gilberto-coelho/Automated-6-Port-Injection-Valve/STL-files/Main Holder.stl

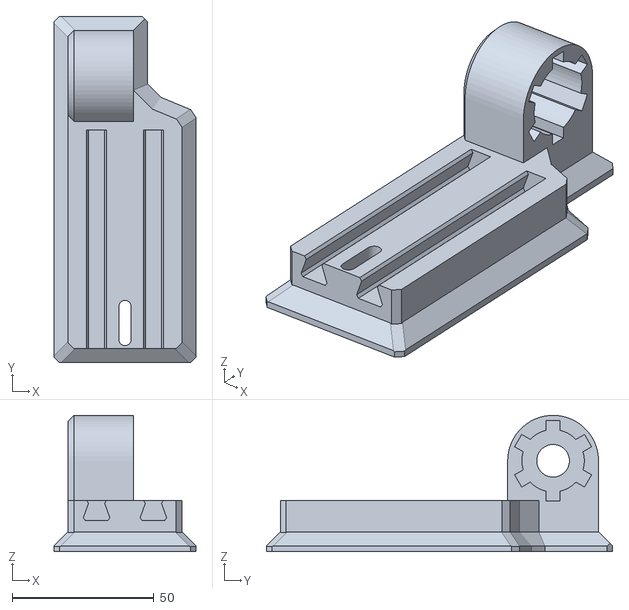
[picture p1: CAD file, 2026-10-12]
STL-files/Main Holder.stl
50.0 x 122.0 x 48.0
