gilberto-coelho/Automated-6-Port-Injection-Valve/STL-files/Gear Servo.stl

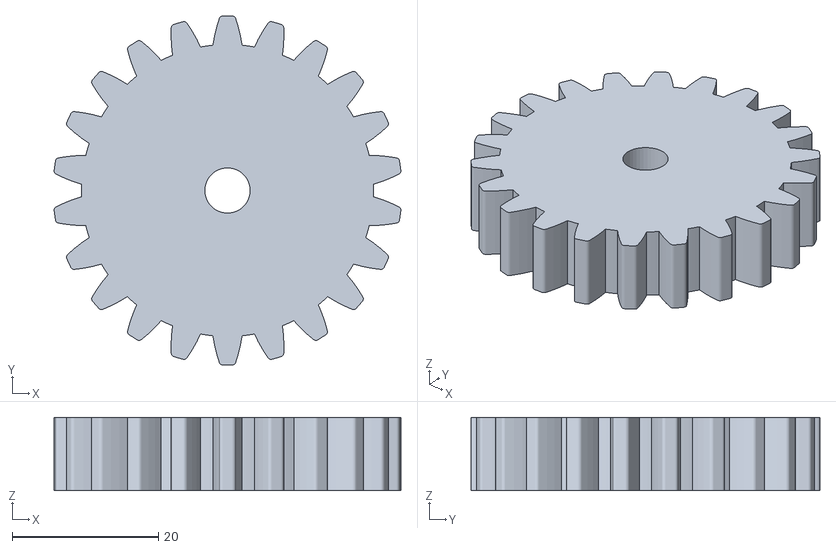
[picture p2: CAD file, 2026-10-12]
STL-files/Gear Servo.stl
47.5 x 47.8 x 10.0
