gilberto-coelho/Automated-6-Port-Injection-Valve/STL-files/Lid.stl

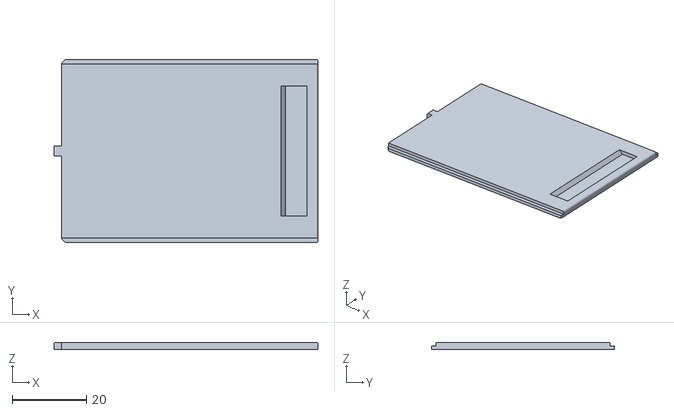
[picture p3: CAD file, 2026-10-12]
STL-files/Lid.stl
71.0 x 49.2 x 2.00
