gilberto-coelho/Automated-6-Port-Injection-Valve/STL-files/Box Electronics.stl

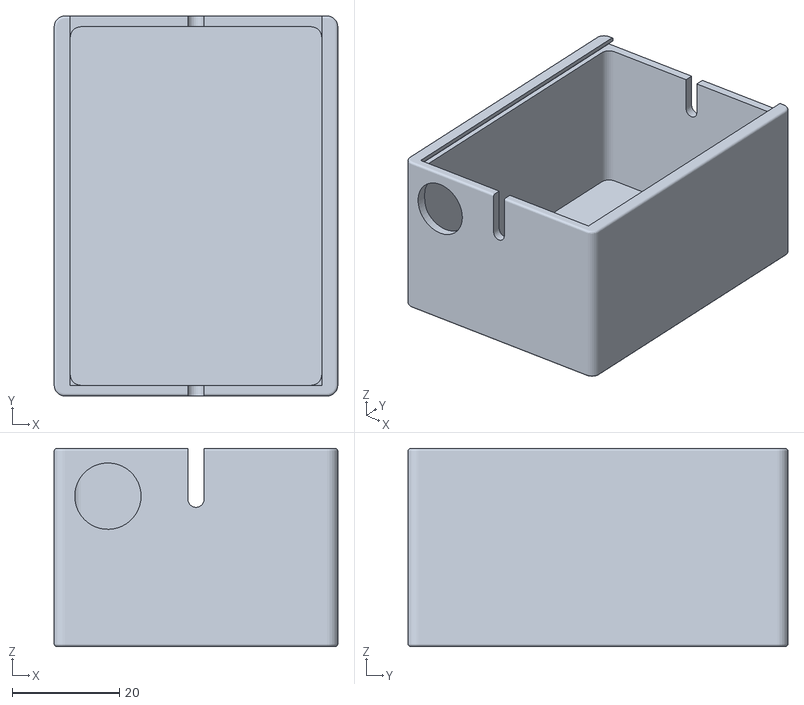
[picture p4: CAD file, 2026-10-12]
STL-files/Box Electronics.stl
53.0 x 71.0 x 37.0
