gilberto-coelho/Automated-6-Port-Injection-Valve/STL-files/Gear valve.stl

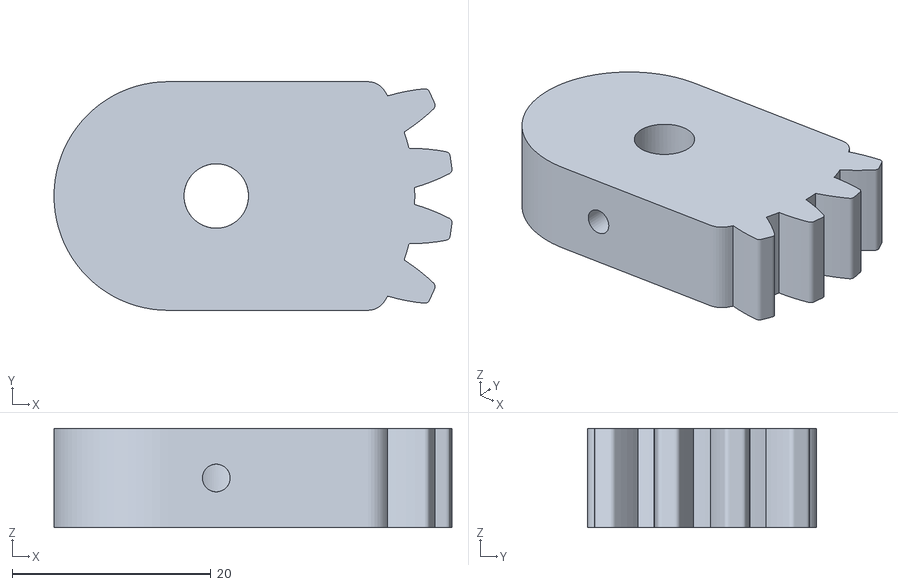
[picture p5: CAD file, 2026-10-12]
STL-files/Gear valve.stl
40.1 x 23.0 x 10.0
