gilberto-coelho/Automated-6-Port-Injection-Valve/STL-files/Holder Servo.stl

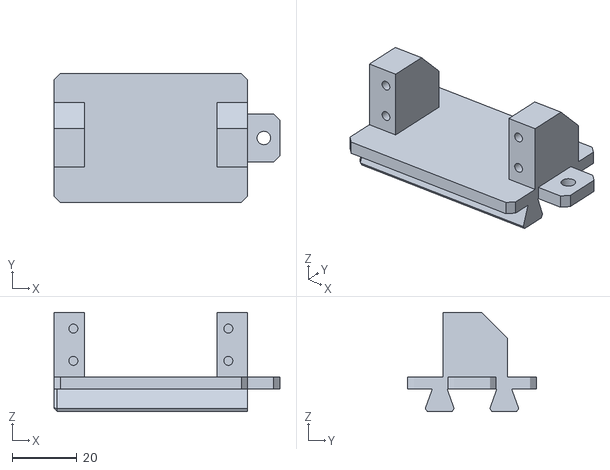
[picture p6: CAD file, 2026-10-12]
STL-files/Holder Servo.stl
70.0 x 40.0 x 30.7
