gilberto-coelho/Automated-6-Port-Injection-Valve/(commit log)

2026-10-12 Add injection valve information to README
2026-10-16 Revise injection valve description in README
